inets-rwth/turn-table/hardware/parts_list.pdf

part | details | price [€] | # | total [€] | hyperlink
electronics
heatsink | 0,98 | 2 | 1,96 http://www.exp-tech.de/smd-kuehlkoerper-6-3x8x4-8mm-fuer-pololu-a4983-a4988
motor mounting | 3,76 | 1 | 3,76 http://www.exp-tech.de/pololu-stamped-aluminum-l-bracket-for-nema-17-stepper-motors?___SID=U
motordriver | 1 A/phase | 9,3 | 2 | 18,6 http://www.exp-tech.de/shields-module/motorsteuerung/schrittmotor/pololu-a4988-schrittmotor-treiber-mit-spannungsregler
pushbutton | 0,95 | 1 | 0,95 http://www.exp-tech.de/16mm-panel-mount-momentary-pushbutton-green
accelerometer | 8,5 | 1 | 8,5 http://www.exp-tech.de/pololu-lsm303d-3d-compass-and-accelerometer-carrier-with-voltage-regulator
reflectance sensor | 4,05 | 2 | 8,1 http://www.exp-tech.de/qtr-1a-reflectance-sensor-2-pack
microUSB cable | 1,8 m | 4,75 | 1 | 4,75 http://www.exp-tech.de/pro-signal-rpusb1-8-micro-usb-kabel-1-8m
wall plug transformer | 12 V, max. 2,25 A | 18,99 | 1 | 18,99 https://www.conrad.de/de/steckernetzteil-festspannung-voltcraft-fpps-12-27w-12-vdc-2250-ma-27-w-512886.html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
socket | 1,13 | 1 | 1,13 https://www.conrad.de/de/niedervolt-steckverbinder-buchse-einbau-vertikal-55-mm-21-mm-072335-1-st-733946.html
main switch | 1,16 | 1 | 1,16 https://www.conrad.de/de/wippschalter-250-vac-10-a-1-x-ausein-a12131121000-rastend-1-st-701661.html
strand | 2x 0,75 mm² | 5,39 | 1 | 5,39 https://www.conrad.de/de/litze-2-x-075-mm-schwarz-conrad-sh1467-10-m-604848.html
strand | 0,14 mm² | 2,95 | 1 | 2,95 https://www.conrad.de/de/litze-liy-1-x-014-mm-blau-conrad-sh1880-10-m-604956.html
shrink tubing | 2,46 | 1 | 2,46 https://www.conrad.de/de/schrumpfschlauch-deray-i-3000-vornach-schrumpfung-64-mm2-mm-schrumpfrate-31-schwarz-532509.html
cable relief | 0,39 | 1 | 0,39 https://www.conrad.de/de/zugentlastung-adels-contact-zel-110-weiss-1-st-409160.html
stepper motor | 35 Ncm | 35,99 | 2 | 71,98 http://www.conrad.de/ce/de/product/198735/Trinamic-QMot-Schrittmotor-Hybrid-18-QSH4218-41-10-035-0-40-VDC-Halte-Moment-035-Nm-Phasen-Strom-max-1-A-Welle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

mechanics
small ballbearing | 8 mm | 5,99 | 2 | 11,98 https://www.conrad.de/de/radial-rillenkugellager-mit-flansch-12-mm-8-mm-35-mm-229653.html
threaded rod | M6 x 500 | 2,29 | 1 | 2,29 https://www.conrad.de/de/modelcraft-stahl-gewindestange-500-mm-m6-237124.html
big cog | 120 t | 8,99 | 1 | 8,99 https://www.conrad.de/de/stirnzahnrad-aus-acetalharz-modul-1-120-237647.html
toothwheel | 18 t | 4,39 | 1 | 4,39 https://www.conrad.de/de/zahnscheibe-htd0185m009-stahl-anzahl-zaehne-18-passend-fuer-riemenbreite-9-mm-1001526.html
belt | 1200 mm, HTD5M | 8,29 | 1 | 8,29 https://www.conrad.de/de/zahnriemen-sit-htd-profil-5m-breite-9-mm-gesamtlaenge-1200-mm-anzahl-zaehne-240-1002137.html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
small cog | m1, 12 Z | 4,49 | 1 | 4,49 https://www.conrad.de/de/zahnrad-aus-stahl-modul-1-14-mm-12-240311.html?sc.queryFromSuggest=true
big axial bearing | 330 mm | 47,01 | 1 | 47,01 http://shop.drehteller.com/Drehkraenze/Alu-Druckguss/Durchmesser-330/Drehkranz-330-03-6xM6::316.html
shaft | 8 mm x 500 mm | 5,49 | 1 | 5,49 https://www.conrad.de/de/silberstahl-welle-500-mm-8-mm-237205.html?sc.queryFromSuggest=true

244
