inets-rwth/turn-table/hardware/Turntable-0.stl

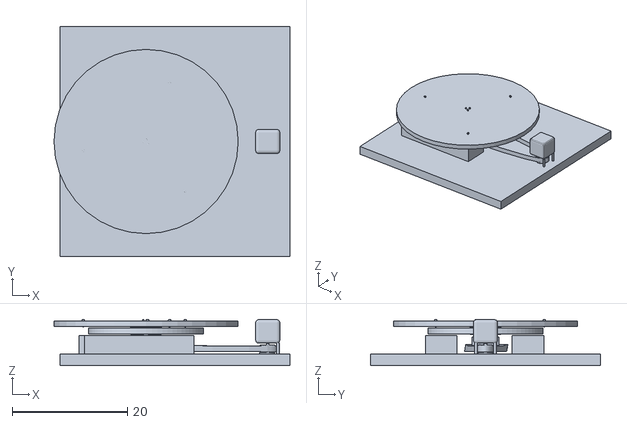
[picture p1: CAD file, 2016-09-22]
hardware/Turntable-0.stl
41.0 x 40.0 x 8.06
