inets-rwth/turn-table/hardware/Turntable-1.stl

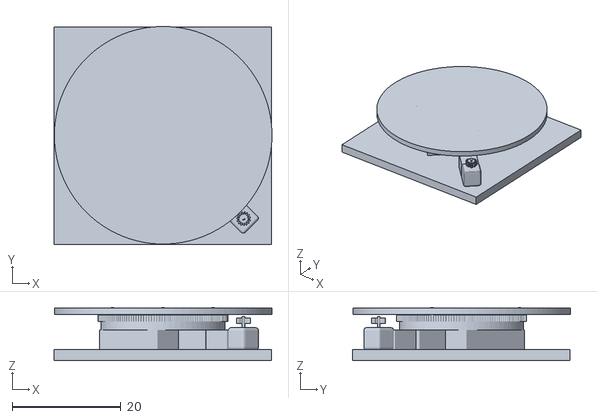
[picture p2: CAD file, 2016-09-22]
hardware/Turntable-1.stl
40.1 x 40.1 x 9.74
