inets-rwth/turn-table/hardware/ballbearing_315mm.pdf

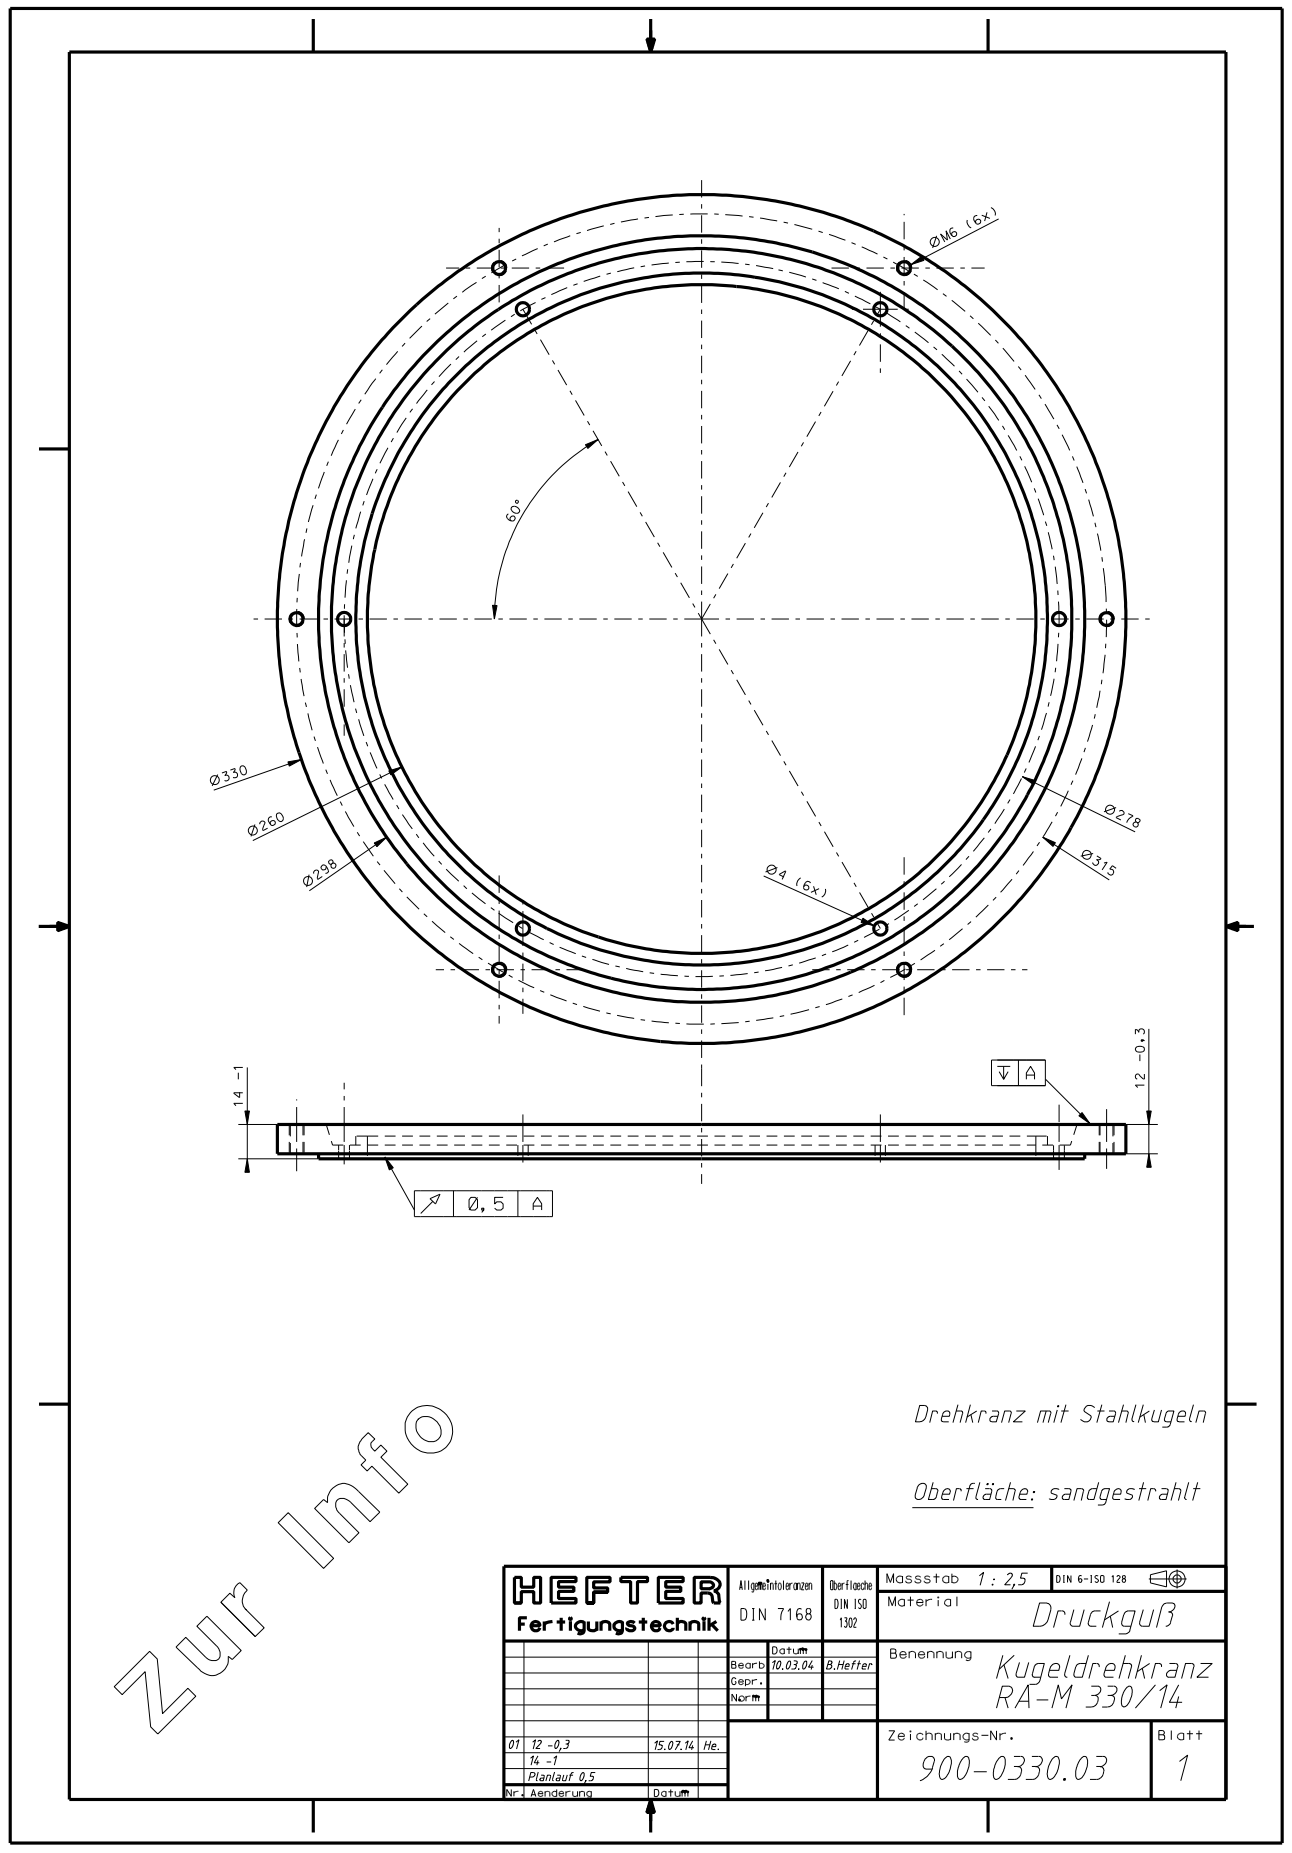
[picture p3: page 1]
