inets-rwth/turn-table/hardware/ballbearing_214mm.pdf

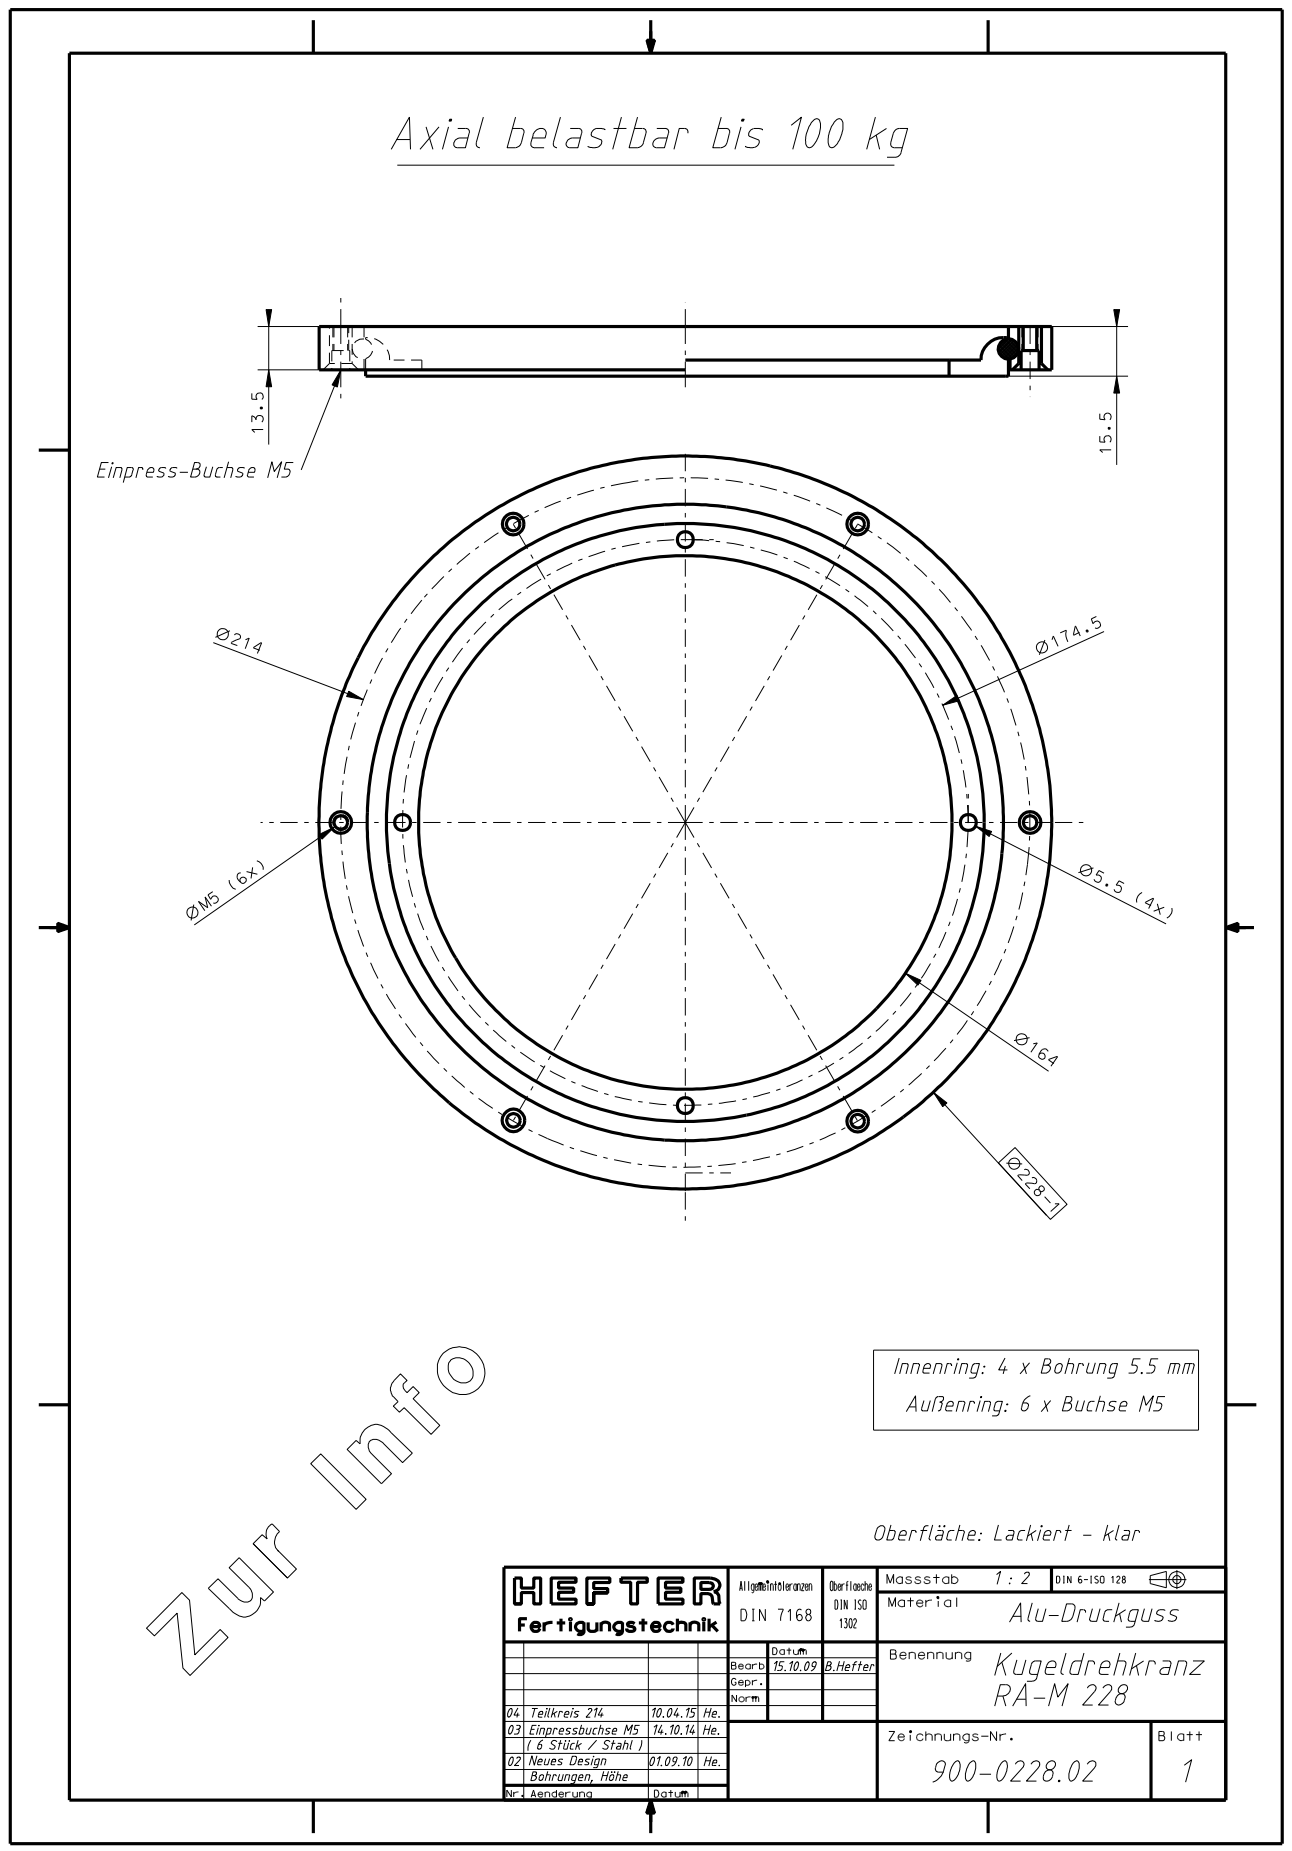
[picture p4: page 1]
