inets-rwth/turn-table/(commit log)

2015-08-25 braketorque enabled, specsheets added
2016-06-27 userguide added
    [Turntable-0.stl, Turntable-1.stl, toothwheel.scad]
